anir377/MiniController_STM32/Projet_KICAD/Projet_PCBPolytech_git.kicad_sch

## KiCad design Projet_KICAD/Projet_PCBPolytech_git.kicad_sch (2026-11-03, an earlier design)

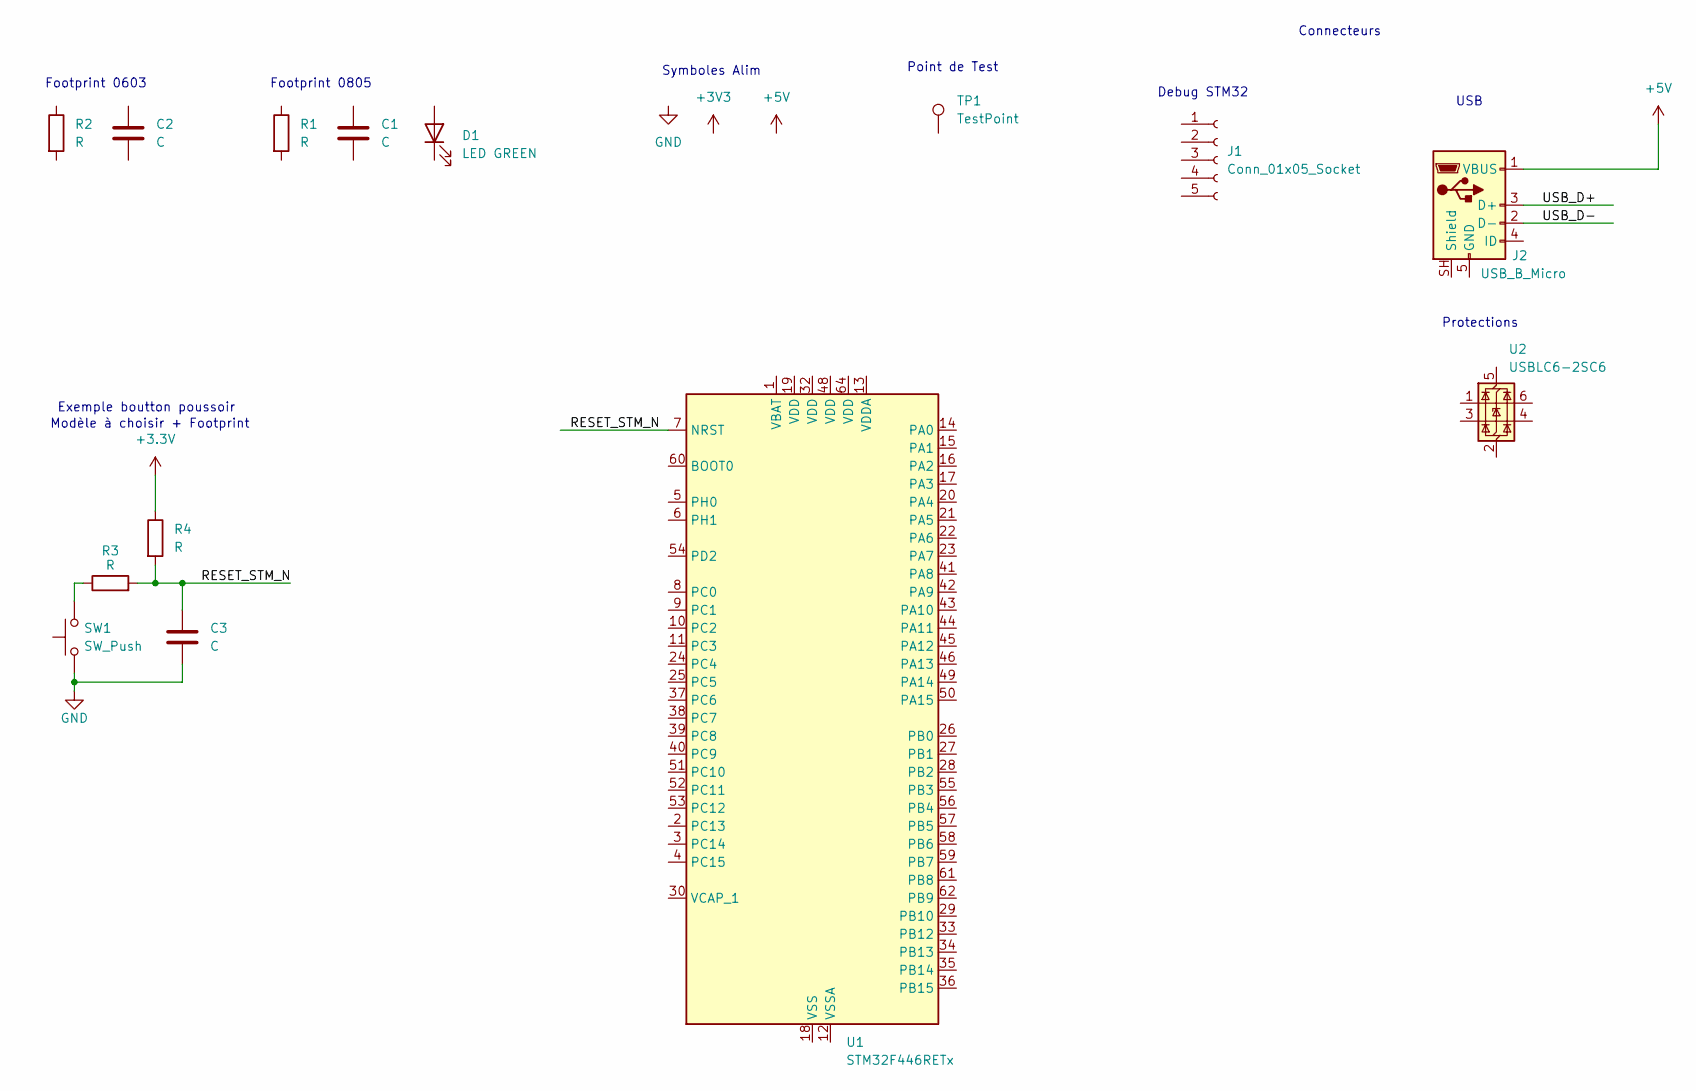
[picture p1: schematic Projet_PCBPolytech_git.kicad_sch]

Parts:
C1, C3: C; C_0805_2012Metric
C2: C; C_0603_1608Metric
D1: LED GREEN; LED_0805_2012Metric
J1: Conn_01x05_Socket; PinHeader_1x05_P2.54mm_Vertical
J2: USB_B_Micro; USB_Micro-AB_Molex_47590-0001
R1, R3, R4: R; R_0805_2012Metric
R2: R; R_0603_1608Metric
SW1: SW_Push; SW_Push_1P1T_NO_CK_KSC6xxG
TP1: TestPoint; TestPoint_Pad_D2.0mm
U1: STM32F446RETx; LQFP-64_10x10mm_P0.5mm
U2: USBLC6-2SC6; SOT-23-6_Handsoldering

Connections:
+3.3V: R4.1
+5V: J2.1 (VBUS)
GND: C3.2, SW1.1
unnamed: R3.1, SW1.2
unnamed: U1.18 (VSS), U1.31 (VSS), U1.47 (VSS), U1.63 (VSS)
RESET_STM_N: C3.1, R3.2, R4.2, U1.7 (NRST)
USB_D+: J2.3 (D+)
USB_D-: J2.2 (D-)

Notes on the sheet:
Footprint 0805
Symboles Alim
Connecteurs
Footprint 0603
Debug STM32
Exemple boutton poussoir
Protections
Point de Test
Modèle à choisir + Footprint
USB
