anir377/MiniController_STM32/Projet_KICAD/gameboy.kicad_sch

## KiCad design Projet_KICAD/gameboy.kicad_sch (2026-11-05, an earlier design)

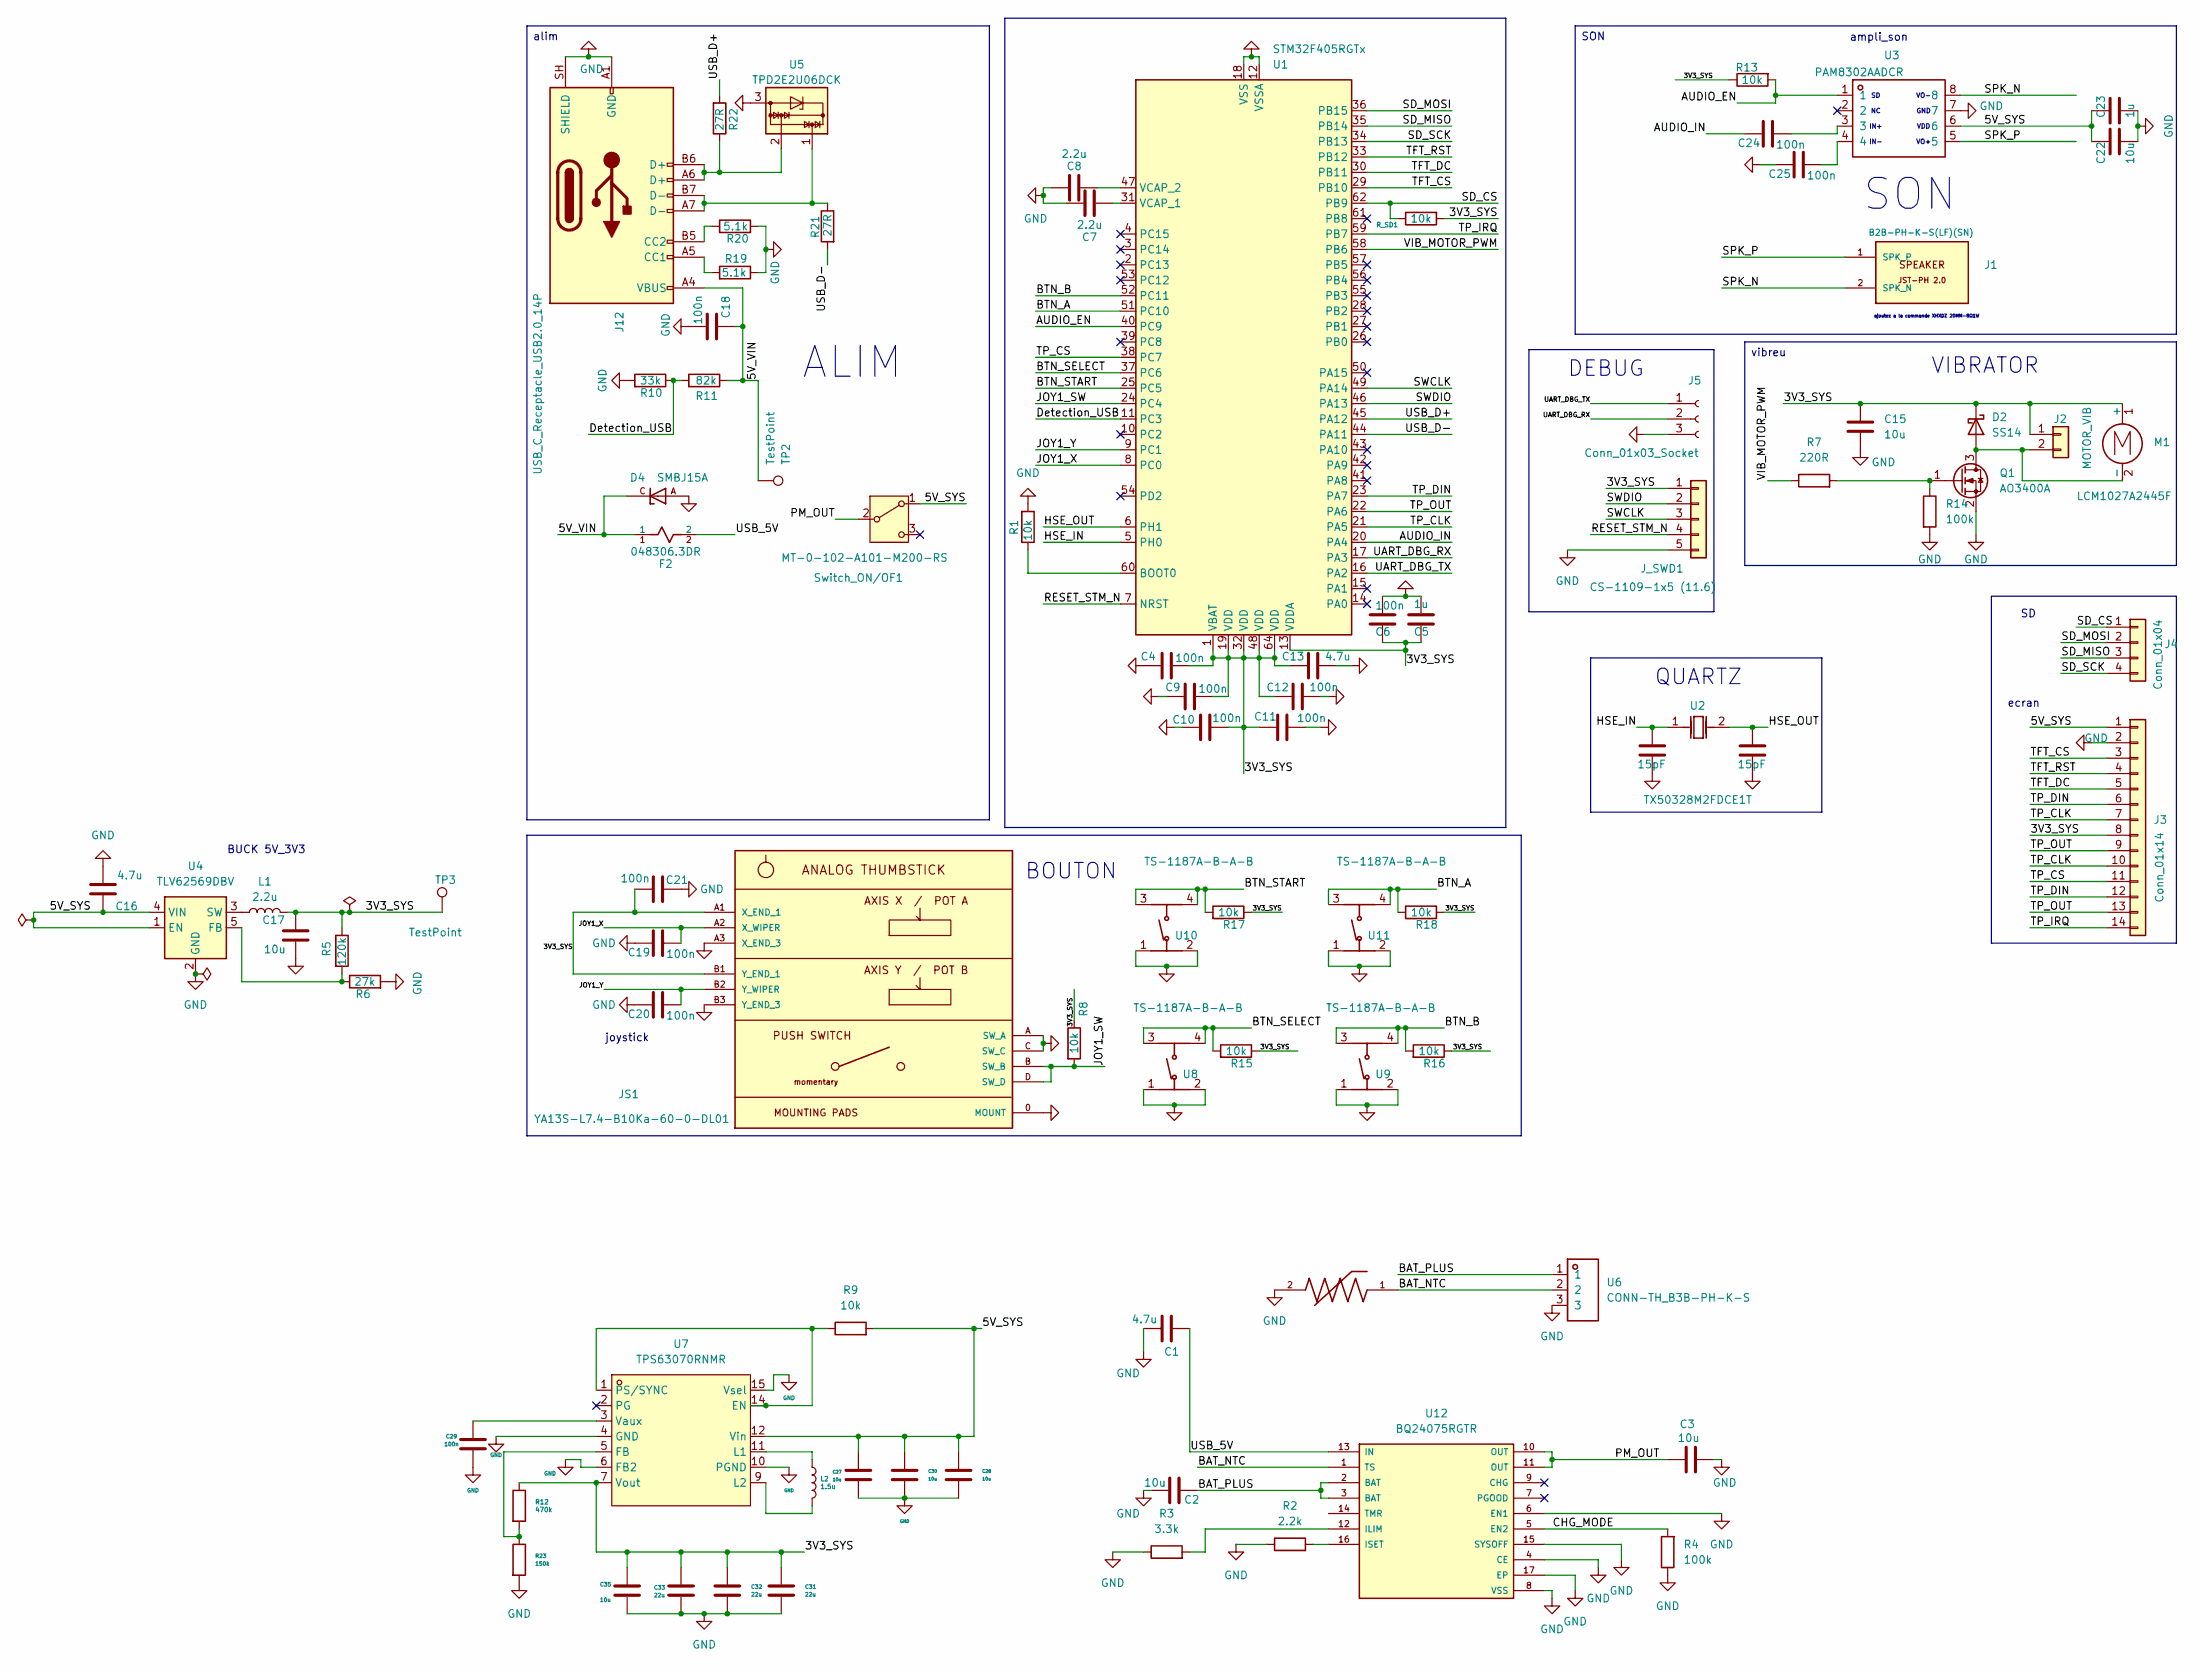
[picture p2: schematic gameboy.kicad_sch]

Parts:
C1: 4.7u
C2, C3, C28, C30, C35: 10u
C4, C6, C9, C10, C11, C12: 100n; C_0805_2012Metric
C5: 1u; C_0805_2012Metric
C7, C8: 2.2u; C_0805_2012Metric
C13: 4.7u; C_0805_2012Metric
C14, C26: 15pF; C_0603_1608Metric
C15, C17: 10u; C_0805_2012Metric; LCSC C15850
C16: 4.7u; C_0805_2012Metric; LCSC C49326719
C18: 100n; C_0603_1608Metric; LCSC C108079
C19, C20, C21, C24, C25: 100n; C_0805_2012Metric; LCSC C49326719
C22: 10u; C_0805_2012Metric; LCSC C49326719
C23: 1u; C_0805_2012Metric; LCSC C49326719
C27: 10u; PQFP-160_28x28mm_P0.65mm
C29: 100n
C31, C32, C33: 22u
D2: SS14; D_SMA; LCSC C2480
D4: SMBJ15A; DIOM4336X265N; PARTREV F2102
F2: 048306.3DR; Fuse_Littelfuse_483_1206
J1: B2B-PH-K-S(LF)(SN); JST_PH_B2B-PH-K_1x02_P2.00mm_Vertical; LCSC Part C131337
J2: MOTOR_VIB; SolderWire-0.1sqmm_1x02_P3.6mm_D0.4mm_OD1mm_Relief
J3: Conn_01x14
J4: Conn_01x04
J5: Conn_01x03_Socket
J12: USB_C_Receptacle_USB2.0_14P; USB-C_perso; LCSC C7095263
JS1: YA13S-L7.4-B10Ka-60-0-DL01; RES-ADJ-TH_YA13S-L7.4-B10KA-60-0-DL01; LCSC Part C37323748
J_SWD1: CS-1109-1x5 (11.6); PinHeader_1x05_P2.54mm_Vertical; LCSC C5142872
L1: 2.2u; L_Bourns-SRN4018; LCSC C913207
L2: 1.5u; PQFP-160_28x28mm_P0.65mm
M1: LCM1027A2445F; LCSC C2759984
Q1: AO3400A; SOT-23; LCSC C20917
R1: 10k; R_0603_1608Metric
R2: 2.2k; PQFP-160_28x28mm_P0.65mm
R3: 3.3k; PQFP-160_28x28mm_P0.65mm
R4: 100k
R5: 120k; R_0805_2012Metric; LCSC C17436
R6: 27k; R_0805_2012Metric; LCSC C17593
R7: 220R; R_0603_1608Metric; LCSC C2889424
R8, R13, R15, R16, R17, R18: 10k; R_0805_2012Metric; LCSC C17593
R9: 10k
R10: 33k; R_0603_1608Metric; LCSC C23254
R11: 82k; R_0603_1608Metric; LCSC C4216
R12: 470k
R14: 100k; R_0603_1608Metric; LCSC C25803
R19, R20: 5.1k; R_0805_2012Metric; LCSC C2912598
R21, R22: 27R; R_0805_2012Metric; LCSC C2889467
R23: 150k
RT1: NCP18XH103F03RB; R_0603_1608Metric; LCSC C13564
R_SD1: 10k; R_0603_1608Metric
Switch_ON/OF1: MT-0-102-A101-M200-RS; Interrupteur_MT-0-102-A101-M200-RS; LCSC C1788492
TP2, TP3: TestPoint; TestPoint_Pad_D2.0mm
U1: STM32F405RGTx; LQFP-64_10x10mm_P0.5mm; LCSC Part # C15742
U2: TX50328M2FDCE1T; Crystal_SMD_5032-2Pin_5.0x3.2mm; LCSC C5182763
U3: PAM8302AADCR; SOIC-8_3.9x4.9mm_P1.27mm; LCSC C112137
U4: TLV62569DBV; SOT-23-5; LCSC C141836
U5: TPD2E2U06DCK; SOT-323_SC-70; LCSC C1855726
U6: CONN-TH_B3B-PH-K-S
U7: TPS63070RNMR; VQFN-15_L3.0-W2.5-P0.50-BL; MPN TPS63070RNMR; LCSC Part C109322
U8, U9, U10, U11: TS-1187A-B-A-B; SW-SMD_4P-L5.1-W5.1-P3.70-LS6.5-TL_H1.5; LCSC C318884
U12: BQ24075RGTR

Connections:
3V3_SYS: C4.2, C5.1, C6.1, C9.1, C10.2, C11.2, C12.1, C13.1, C15.1, C17.1, C21.1, C31.1, C32.1, C33.1, C35.1, D2.1 (K), J2.1, J3.8, JS1.A1 (X_END_1), JS1.B1 (Y_END_1), J_SWD1.1, L1.2, M1.1 (+), R5.1, R8.1, R12.1, R13.1, R15.1, R16.1, R17.1, R18.1, R_SD1.2, TP3.1, U1.1 (VBAT), U1.13 (VDDA), U1.19 (VDD), U1.32 (VDD), U1.48 (VDD), U1.64 (VDD), U7.7 (Vout)
5V_SYS: C16.1, C22.1, C23.1, C27.1, C28.1, C30.1, J3.1, R9.2, Switch_ON/OF1.1 (A), U3.6, U4.1 (EN), U4.4 (VIN), U7.12 (Vin)
5V_VIN: C18.1, D4.C, F2.1, J12.A4 (VBUS), J12.A9 (VBUS), J12.B4 (VBUS), J12.B9 (VBUS), R11.1, TP2.1
AUDIO_EN: R13.2, U1.40 (PC9), U3.1
AUDIO_IN: C24.2, U1.20 (PA4)
BAT_NTC: RT1.1, U6.2, U12.1 (TS)
BAT_PLUS: C2.1, U6.1, U12.2 (BAT), U12.3 (BAT)
BTN_A: R18.2, U1.51 (PC10), U11.3, U11.4
BTN_B: R16.2, U1.52 (PC11), U9.3, U9.4
BTN_SELECT: R15.2, U1.37 (PC6), U8.3, U8.4
BTN_START: R17.2, U1.25 (PC5), U10.3, U10.4
CHG_MODE: R4.2, U12.5 (EN2)
Detection_USB: R10.1, R11.2, U1.11 (PC3)
GND: C1.2, C2.2, C3.2, C4.1, C5.2, C6.2, C7.1, C8.1, C9.2, C10.1, C11.1, C12.2, C13.2, C14.1, C15.2, C16.2, C17.2, C18.2, C19.2, C20.2, C21.2, C22.2, C23.2, C25.2, C26.1, C27.2, C28.2, C29.2, C30.2, C31.2, C32.2, C33.2, C35.2, D4.A, J3.2, J5.3, J12.A1 (GND), J12.A12 (GND), J12.B1 (GND), J12.B12 (GND), J12.SH (SHIELD), JS1.0 (MOUNT), JS1.A (SW_A), JS1.A3 (X_END_3), JS1.B3 (Y_END_3), JS1.C (SW_C), J_SWD1.5, Q1.2 (S), R1.2, R2.1, R3.1, R4.1, R6.2, R10.2, R14.2, R19.1, R20.1, R23.2, RT1.2, U1.12 (VSSA), U1.18 (VSS), U1.63 (VSS), U3.7, U4.2 (GND), U5.3, U6.3, U7.4 (GND), U7.6 (FB2), U7.10 (PGND), U7.15 (Vsel), U8.1, U8.2, U9.1, U9.2, U10.1, U10.2, U11.1, U11.2, U12.4 (CE), U12.6 (EN1), U12.8 (VSS), U12.15 (SYSOFF), U12.17 (EP)
HSE_IN: C14.2, U1.5 (PH0), U2.1
HSE_OUT: C26.2, U1.6 (PH1), U2.2
JOY1_SW: JS1.B (SW_B), JS1.D (SW_D), R8.2, U1.24 (PC4)
JOY1_X: C19.1, JS1.A2 (X_WIPER), U1.8 (PC0)
JOY1_Y: C20.1, JS1.B2 (Y_WIPER), U1.9 (PC1)
unnamed: C7.2, U1.31 (VCAP_1)
unnamed: C8.2, U1.47 (VCAP_2)
unnamed: C24.1, U3.3
unnamed: C25.1, U3.4
unnamed: C29.1, U7.3 (Vaux)
unnamed: D2.2 (A), J2.2, M1.2 (-), Q1.3 (D)
unnamed: J12.A5 (CC1), R19.2
unnamed: J12.A6 (D+), J12.B6 (D+), R22.1, U5.2
unnamed: J12.A7 (D-), J12.B7 (D-), R21.1, U5.1
unnamed: J12.B5 (CC2), R20.2
unnamed: L1.1, U4.3 (SW)
unnamed: L2.1, U7.11 (L1)
unnamed: L2.2, U7.9 (L2)
unnamed: Q1.1 (G), R7.2, R14.1
unnamed: R1.1, U1.60 (BOOT0)
unnamed: R2.2, U12.16 (ISET)
unnamed: R3.2, U12.12 (ILIM)
unnamed: R5.2, R6.1, U4.5 (FB)
unnamed: R9.1, U7.1 (PS/SYNC), U7.14 (EN)
unnamed: R12.2, R23.1, U7.5 (FB)
PM_OUT: C3.1, Switch_ON/OF1.2 (B), U12.10 (OUT), U12.11 (OUT)
RESET_STM_N: J_SWD1.4, U1.7 (NRST)
SD_CS: J4.1, R_SD1.1, U1.62 (PB9)
SD_MISO: J4.3, U1.35 (PB14)
SD_MOSI: J4.2, U1.36 (PB15)
SD_SCK: J4.4, U1.34 (PB13)
SPK_N: J1.2 (SPK_N), U3.8
SPK_P: J1.1 (SPK_P), U3.5
SWCLK: J_SWD1.3, U1.49 (PA14)
SWDIO: J_SWD1.2, U1.46 (PA13)
TFT_CS: J3.3, U1.29 (PB10)
TFT_DC: J3.5, U1.30 (PB11)
TFT_RST: J3.4, U1.33 (PB12)
TP_CLK: J3.7, J3.10, U1.21 (PA5)
TP_CS: J3.11, U1.38 (PC7)
TP_DIN: J3.6, J3.12, U1.23 (PA7)
TP_IRQ: J3.14, U1.59 (PB7)
TP_OUT: J3.9, J3.13, U1.22 (PA6)
UART_DBG_RX: J5.2, U1.17 (PA3)
UART_DBG_TX: J5.1, U1.16 (PA2)
USB_5V: C1.1, F2.2, U12.13 (IN)
USB_D+: R22.2, U1.45 (PA12)
USB_D-: R21.2, U1.44 (PA11)
VIB_MOTOR_PWM: R7.1, U1.58 (PB6)

Notes on the sheet:
ampli_son
IN-
QUARTZ
ecran
VO+
VDD
VO-
BUCK 5V_3V3
SON
GND
IN+
joystick
DEBUG
ALIM
BOUTON
VIBRATOR
ajoutez a la commande XHXDZ 20MM-8Ω1W
vibreu
alim
