anir377/MiniController_STM32/MiniConsole_STM32.ioc

Mcu.UserName=STM32F405RGTx
PA13.Signal=SYS_JTMS-SWDIO
PA14.Signal=SYS_JTCK-SWCLK
PA2.Signal=USART2_TX
PA3.Signal=USART2_RX
PA5.Signal=SPI1_SCK
PA6.Signal=SPI1_MISO
PA7.Signal=SPI1_MOSI
PB10.Signal=GPIO_Output
PB11.Signal=GPIO_Output
PB12.Signal=GPIO_Output
PB13.Signal=SPI2_SCK
PB14.Signal=SPI2_MISO
PB15.Signal=SPI2_MOSI
PB6.GPIO_Label=VIB_MOTOR_PWM
PB6.Signal=S_TIM4_CH1
PB7.GPIO_Label=TP_IRQ
PB7.Signal=GPIO_Input
PB9.GPIO_Label=SD_CS
PB9.Signal=GPIO_Output
PC0.Signal=ADCx_IN10
PC1.Signal=ADCx_IN11
PC4.GPIO_Label=JOY1_SW
PC4.Signal=GPIO_Input
PC5.GPIO_Label=BTN_START
PC5.Signal=GPIO_Input
PC6.GPIO_Label=BTN_SELECT
PC6.Signal=GPIO_Input
PC7.GPIO_Label=TP_CS
PC7.Signal=GPIO_Output
PH0-OSC_IN.Signal=RCC_OSC_IN
PH1-OSC_OUT.Signal=RCC_OSC_OUT
