anir377/MiniController_STM32/(commit log)

2026-10-08 docs: préparer la conception PCB de la mini-console
2026-10-22 Update Projet_PCBPolytech_git.kicad_sch
    Mise à jour du schéma STM32F405 et alimentation
2026-10-22 Correction des condensateurs VCAP du STM32
2026-10-22 Update KiCad schematic and add STM32CubeMX configuration
2026-10-22 docs: actualiser la présentation du projet mini-console STM32
2026-10-22 Mise à jour schéma PCB et connexions STM32
2026-10-23 ajout des broches USB
2026-11-03 BUCK removed
